Sophrinix/Acoustic-Tractor-Beam/README.rst

# AcousticTractorBeam

********************************
Acoustic Tractor Beam
********************************
Levitate objects using waves.

Using the guidance from Asier Marzo in his instructable:
http://www.instructables.com/id/Acoustic-Tractor-Beam/?ALLSTEPS

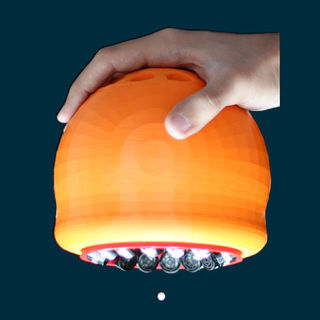
[picture p1: images/1.jpg]
   
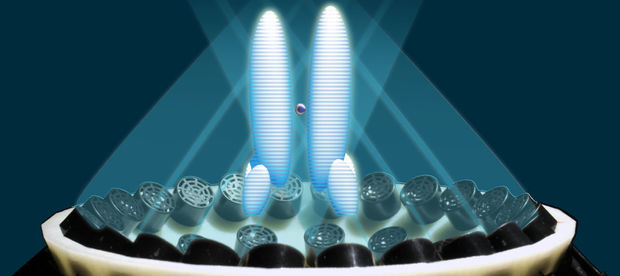
[picture p2: images/2.jpg]
   
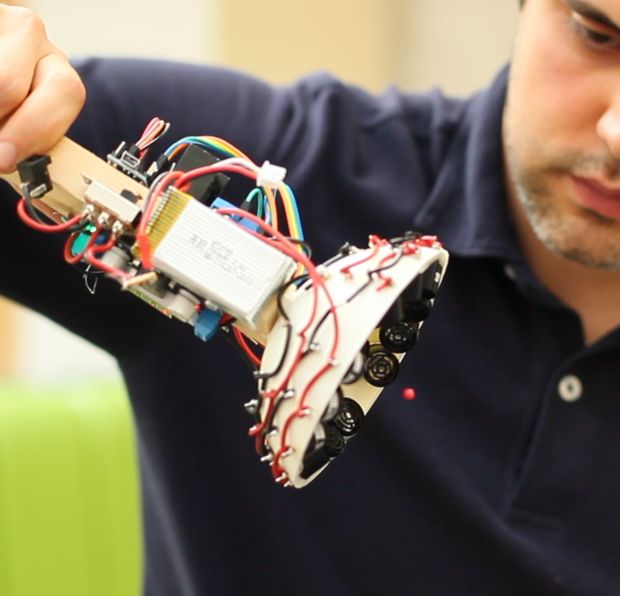
[picture p3: images/3.jpg]
