Sophrinix/Acoustic-Tractor-Beam/docs/AcousticTractorBeam_Instructable.pdf

http://www.instructables.com/id/Acoustic-Tractor-Beam/technology (http://www.instructables.com/tag/type-id/category-technology/) workshop (http://www.instructables.com/tag/type-id/category-workshop/) craft (http://www.instructables.com/tag/type-id/category-craft/) home (http://www.instructables.com/tag/type-id/category-home/) food (http://www.instructables.com/tag/type-id/category-food/) play (http://www.instructables.com/tag/type-id/category-play/) outside (http://www.instructables.com/tag/type-id/category-outside/) costumes (http://www.instructables.com/tag/type-id/category-costumes/)

# Acoustic Tractor Beam

by Asier Marzo on December 13, 2016

Table of Contents

Author:Asier Marzo author's website (http://asiermarzo.wordpress.com)
Researcher at Bristol University interesting in Ultrasound and in general any effects that waves can produce.

## Intro: Acoustic Tractor Beam

Tractor Beams are mysterious waves that can attract particles towards the source. Here, we will show you how to build an Acoustic Tractor Beam with components that can be bought directly on the Internet for less than 75$.

With this Instructable you will be able to get in your hands a device that it was only seen on SciFi movies such as Star Wars or Star Trek.

If you want more scientific background on Acoustic Tractor Beams, you can check our Open Access papers:
How Acoustic Tractor Beams Work (http://www.nature.com/articles/ncomms9661)
Acoustic Delay Lines for Compact Tractor beams (http://aip.scitation.org/doi/full/10.1063/1.4972407)

Do not forget to watch the attached video.

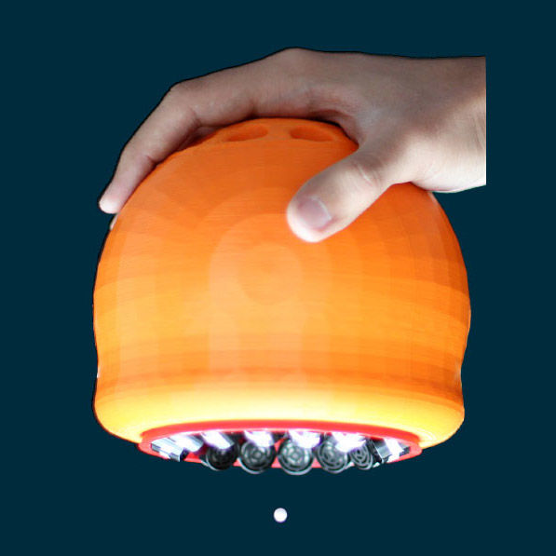
[picture p4: figure]
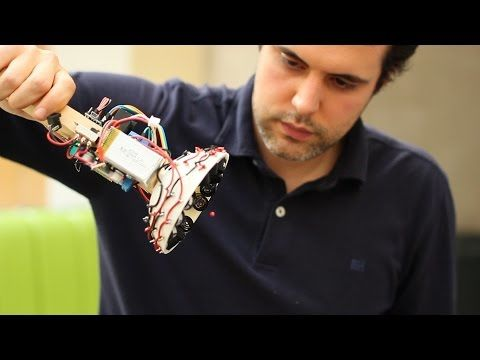
[picture p5: figure]

## Step 1: Gather the parts and tools

We present a list of the necessary components. We are sorry since the links are UK oriented. However, the same parts can be found all around the world, some useful websites are http://www.findchips.com/ http://www.dx.com/ http://www.miniinthebox.com/http://www.lightinthebox.com/

The circuit is not complicated. Basically, an Arduino will generate 4 half-square signals at 5Vpp 40kHz with different phases. These signals get amplified to 25Vpp by the Motor Driver and fed into the transducers. A button pad can be used to change the phases so that the particle moves up and down. A battery (7.3V) powers the Arduino and the logic part of the Motor Driver. A DC-DC Converter steps-up the 7.3V to 25V for the Motor Driver.

Components:
30x 16mm Transducers MCUSD16P40B12RO (http://uk.farnell.com/webapp/wcs/stores/servlet/ProductDisplay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)

1x Arduino Nano (http://www.amazon.co.uk/dp/B015MGHH6Q)
1x L298N Dual Motor Drive Board (http://www.amazon.co.uk/dp/B00GKF60Z8)
1x DCtoDC converter (http://www.amazon.co.uk/dp/B00J0V6MCK)
1x 2S Lipo Battery (7.3V) + charger (http://www.amazon.co.uk/dp/B01AXQN9MG) 11x M3 screws 6mm (http://www.amazon.co.uk/dp/B00DY2980Y) and M3 nuts (http://www.amazon.co.uk/dp/B00O7RRKXC) 1x 300x45x15mm wood piece
1x 3D Printed Bowl
1x Small strip board (http://www.amazon.co.uk/dp/B00KM1EG0M)
1x switch (http://www.amazon.co.uk/dp/B008DFYNX4)
3x breadboard buttons (http://www.amazon.co.uk/dp/B00976KDBY)
Jumper wires (http://www.amazon.co.uk/dp/B018W4L6D0)
12AWG black and red wire (http://www.amazon.co.uk/dp/B01H1WMCT6)
Some Expanded Polystyrene beads to levitate (between 1mm and 4mm diameter) An acoustically transparent material: A metallic grid, very thin fabric or teabag paper.

Necessary Tools:
3D printer -> you can use an online service

Oscilloscope with two probes -> you can get one for less than 50£ http://amzn.eu/5ey6ty2

Soldering Iron, Tin and Flux.
Drill
Hot-glue gun
Multimeter
Cable Peeler
Screwdriver and Pliers.

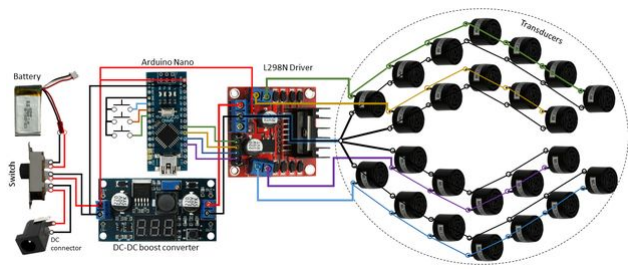
[picture p6: figure]

## Step 2: 3D print the bowl

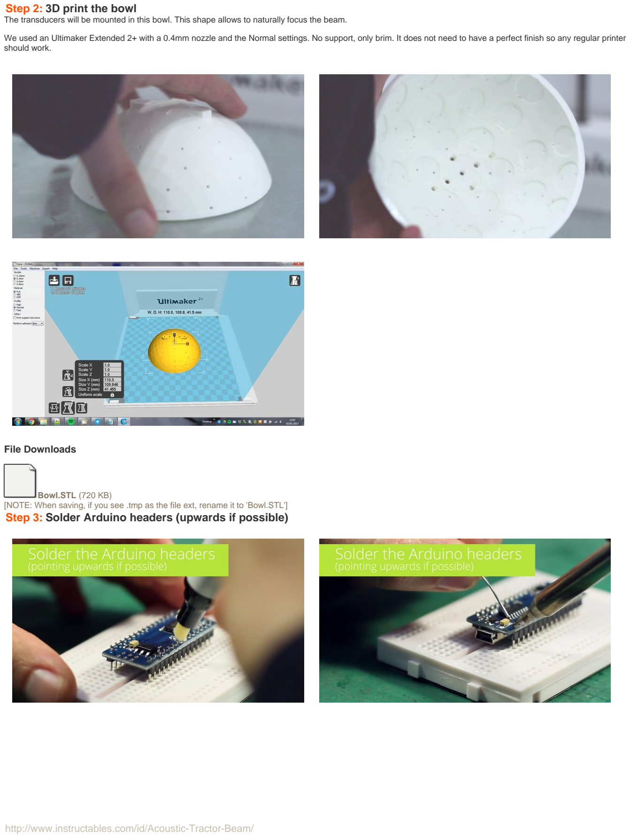
[picture p7: page 5]

The transducers will be mounted in this bowl. This shape allows to naturally focus the beam.

We used an Ultimaker Extended 2+ with a 0.4mm nozzle and the Normal settings. No support, only brim. It does not need to have a perfect finish so any regular printer should work.

File Downloads

Bowl.STL (http://www.instructables.comhttps://cdn.instructables.com/ORIG/FM7/UD6W/IWMQUV05/FM7UD6WIWMQUV05.stl) (720 KB)
[NOTE: When saving, if you see .tmp as the file ext, rename it to 'Bowl.STL'] (http://www.instructables.comhttps://cdn.instructables.com/ORIG/FM7/UD6W/IWMQUV05/FM7UD6WIWMQUV05.stl)

## Step 3: Solder Arduino headers (upwards if possible)

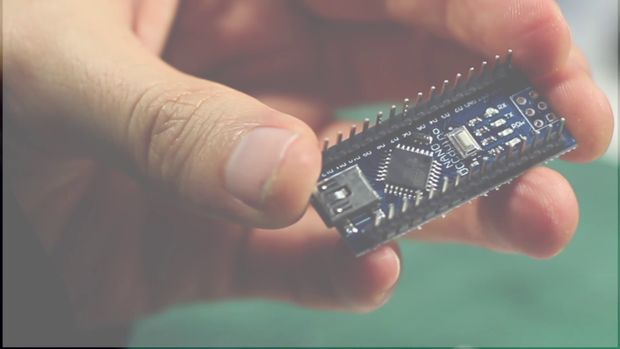
[picture p8: figure]

## Step 4: Program Arduino

Upload the attached program in the Arduino Nano. If you are using a cheap Nano (totally recommendable) you will need to install new drivers, there are usually links in the webpage where you bought it.

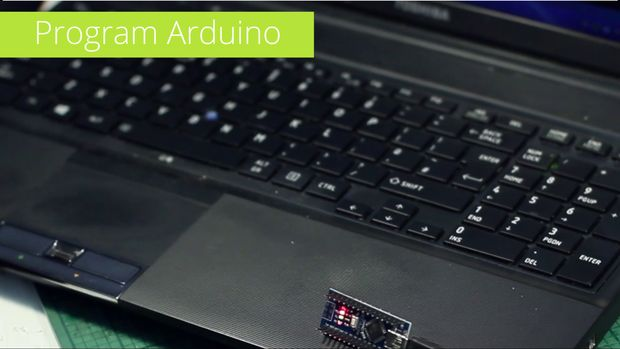
[picture p9: figure]

File Downloads

DriverNano_tractor.ino (http://www.instructables.comhttps://cdn.instructables.com/ORIG/F32/XCJP/IWMQUV4D/F32XCJPIWMQUV4D.ino) (7 KB)
[NOTE: When saving, if you see .tmp as the file ext, rename it to 'DriverNano_tractor.ino'] (http://www.instructables.comhttps://cdn.instructables.com/ORIG/F32/XCJP/IWMQUV4D/F32XCJPIWMQUV4D.ino)

## Step 5: Charge the battery

This way when you finish the project it will be at full charge.

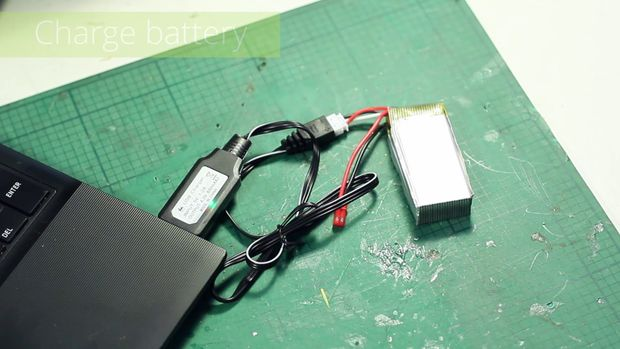
[picture p10: figure]

## Step 6: Cut the handler

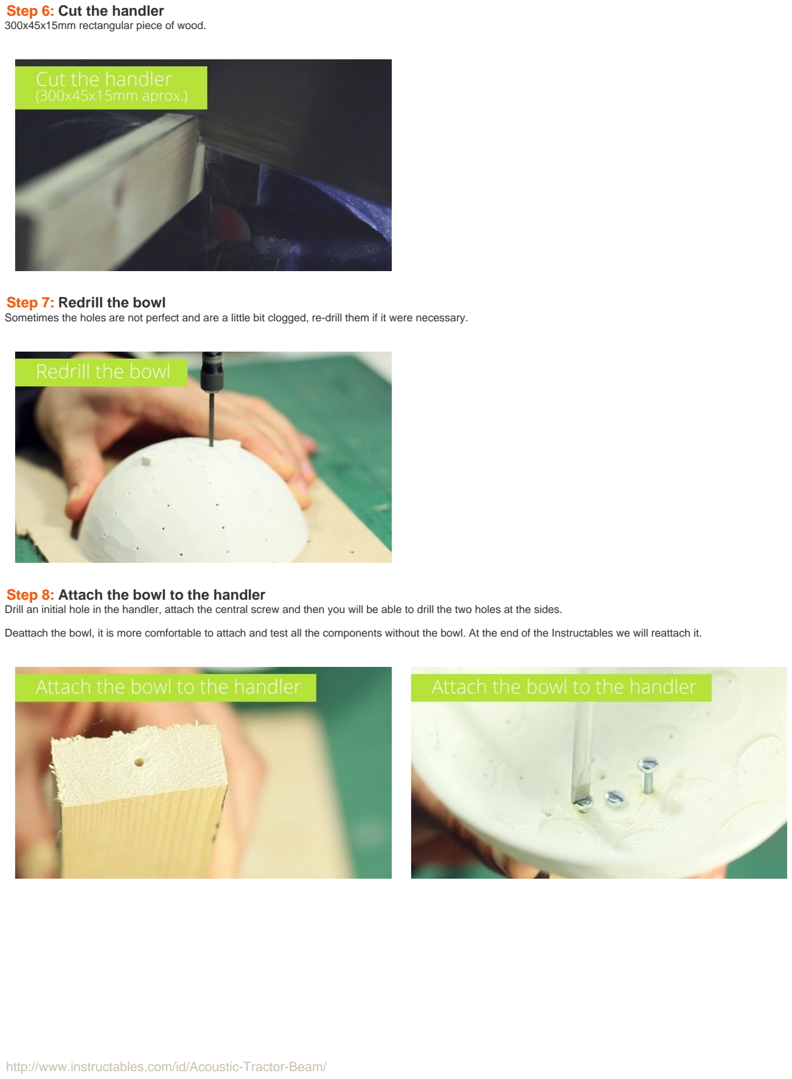
[picture p11: page 7]

300x45x15mm rectangular piece of wood.

## Step 7: Redrill the bowl

Sometimes the holes are not perfect and are a little bit clogged, re-drill them if it were necessary.

## Step 8: Attach the bowl to the handler

Drill an initial hole in the handler, attach the central screw and then you will be able to drill the two holes at the sides.

Deattach the bowl, it is more comfortable to attach and test all the components without the bowl. At the end of the Instructables we will reattach it.

## Step 9: Screw the DCConverter and the Driver

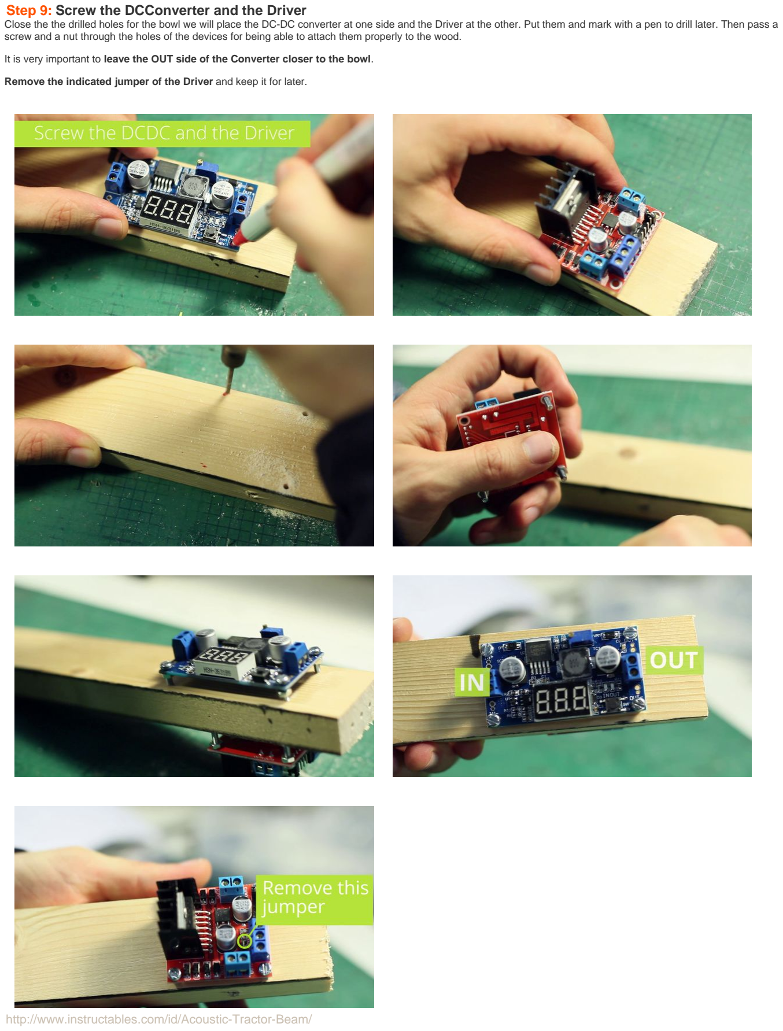
[picture p12: page 8]

Close the the drilled holes for the bowl we will place the DC-DC converter at one side and the Driver at the other. Put them and mark with a pen to drill later. Then pass a screw and a nut through the holes of the devices for being able to attach them properly to the wood.

It is very important to leave the OUT side of the Converter closer to the bowl.

Remove the indicated jumper of the Driver and keep it for later.

## Step 10: Stick the arduino

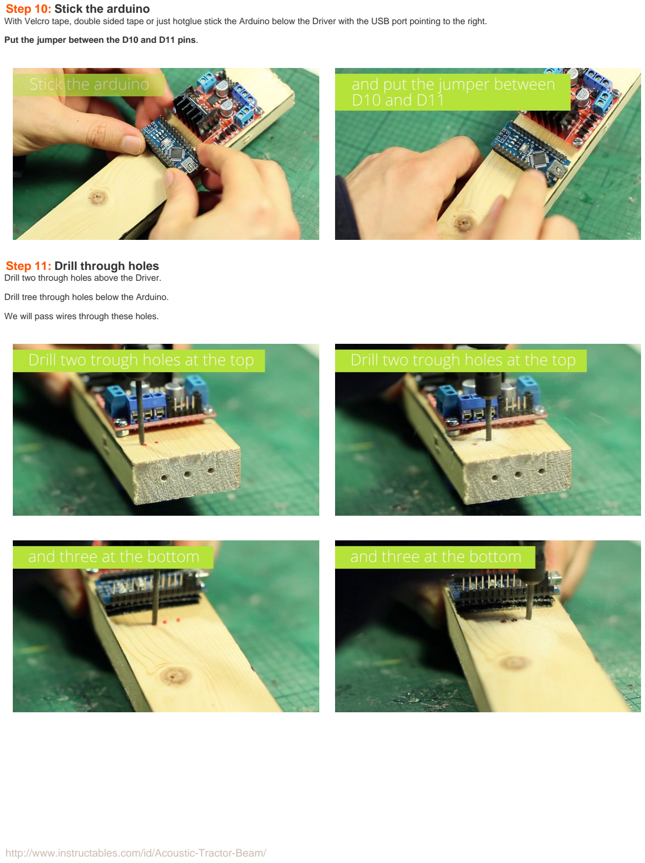
[picture p13: page 9]

With Velcro tape, double sided tape or just hotglue stick the Arduino below the Driver with the USB port pointing to the right.

Put the jumper between the D10 and D11 pins.

## Step 11: Drill through holes

Drill two through holes above the Driver.

Drill tree through holes below the Arduino.

We will pass wires through these holes.

## Step 12: Solder wires to the power switch

The central pins provides the current to the circuit, the right pins go to the DC barrel and the left ones to the battery connector pins.

Try to use red wires for (+) and black for ground (-) to keep things ordered. Pay attention to where the + and - of the DC barrel go and solder it appropriately.

For the battery connector pins we can use pin headers and a tiny piece of strip-board. Be sure that the wires are not touching each other (use a multimeter), and even put hotglue between them to make them safer.

The power switch provides current to the circuit either from a DC barrel or from the battery.

We can use any DC adaptor between 9V and 12V that can provide at least 2A if you do not want to use a battery.

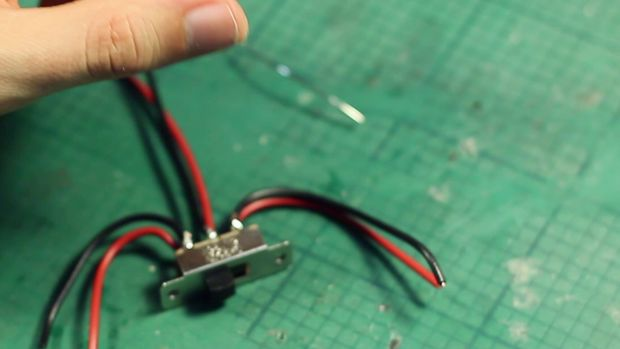
[picture p14: figure]
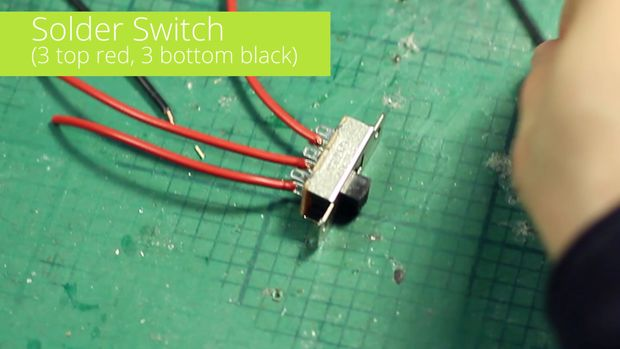
[picture p15: figure]
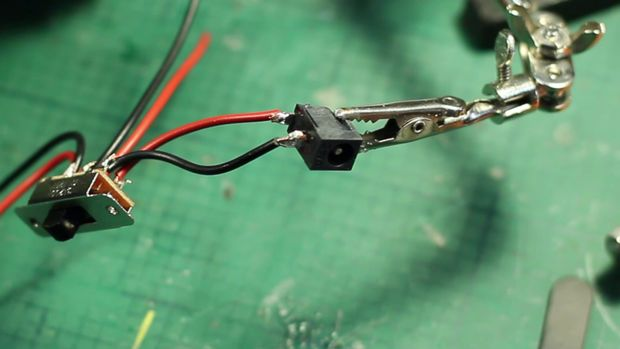
[picture p16: figure]
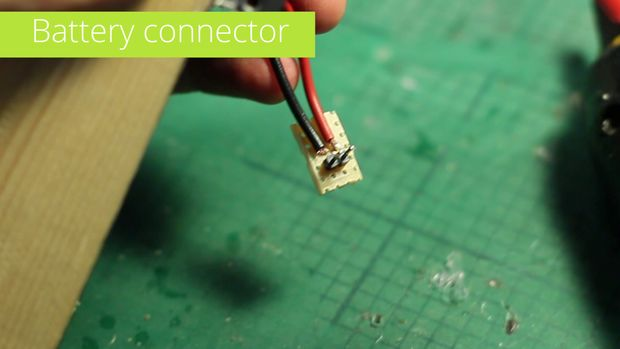
[picture p17: figure]
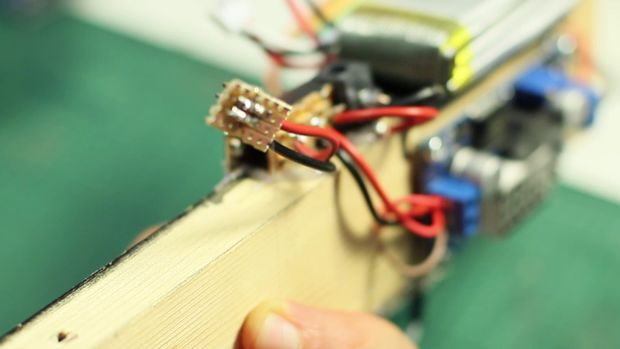
[picture p18: figure]

## Step 13: Stick the battery

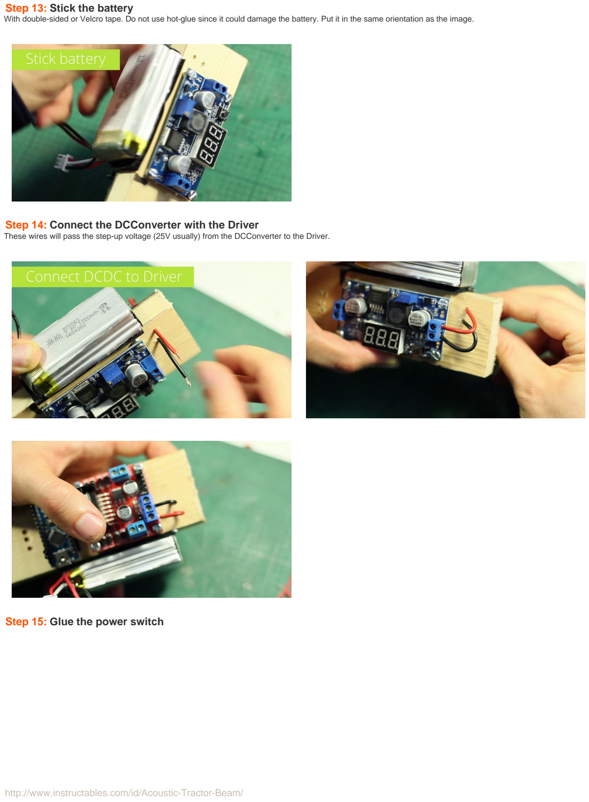
[picture p19: page 11]

With double-sided or Velcro tape. Do not use hot-glue since it could damage the battery. Put it in the same orientation as the image.

## Step 14: Connect the DCConverter with the Driver

These wires will pass the step-up voltage (25V usually) from the DCConverter to the Driver.

## Step 15: Glue the power switch

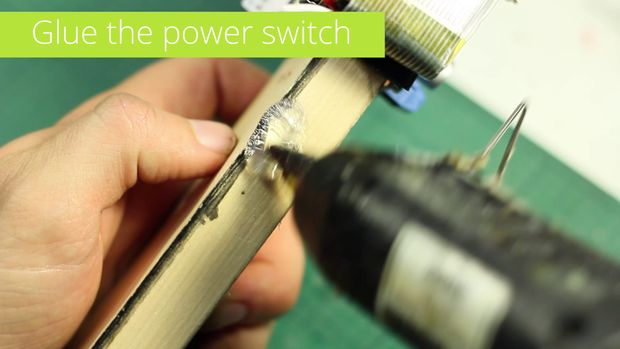
[picture p20: figure]
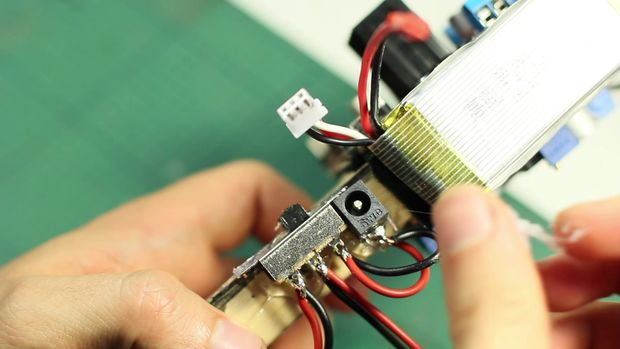
[picture p21: figure]

## Step 16: Connect logic supply

We will provide 7.4V to the DCConverter IN.

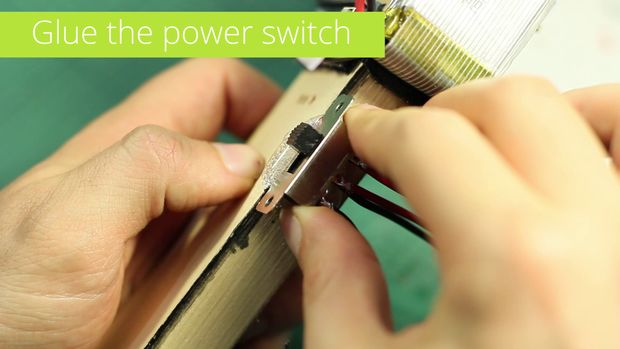
[picture p22: figure]

First connect the black ground wire (-) from the central pins of the Switch into the DCConverter IN(-), in the same hole connect the ground for the Arduino.

Then, connect the red (+) wire from the central pin of Switch into the DCConverter IN(+), in the same hole put the VIn of the Arduino and the logic supply for the converter (pins from where we removed the jumper, very important to connect it into the highlighted pin).

Tining the tips of the wires will facilitate putting several wires in the same hole.

It is also possible to get voltage for the Arduino from the DCConverter. Instead of connecting Converter.IN(+) to Arduino.VIn, we can use DCConverter(5V) to Arduino(V5).

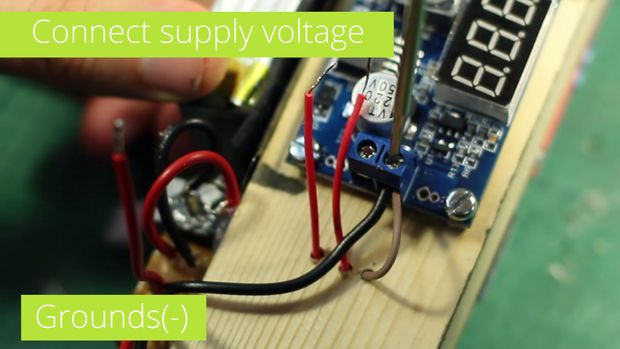
[picture p23: figure]
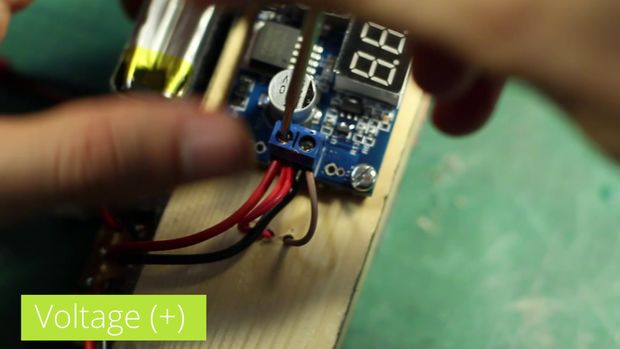
[picture p24: figure]

## Step 17: Connect signal wires

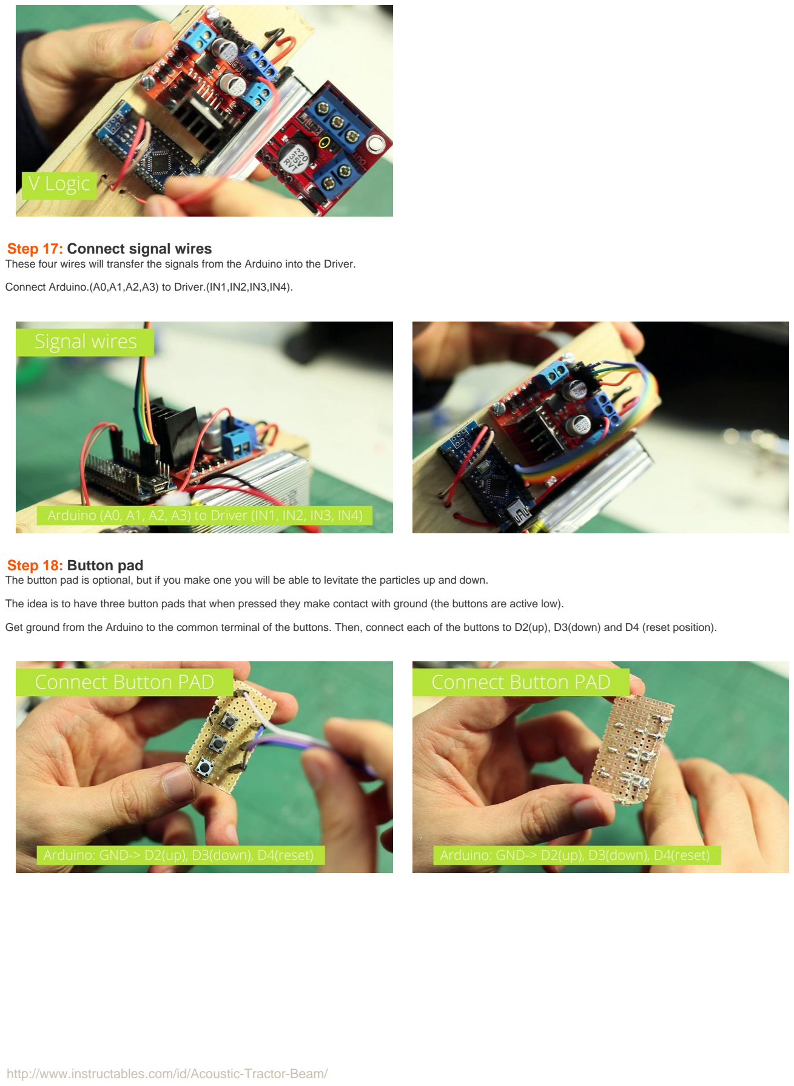
[picture p25: page 13]

These four wires will transfer the signals from the Arduino into the Driver.

Connect Arduino.(A0,A1,A2,A3) to Driver.(IN1,IN2,IN3,IN4).

## Step 18: Button pad

The button pad is optional, but if you make one you will be able to levitate the particles up and down.

The idea is to have three button pads that when pressed they make contact with ground (the buttons are active low).

Get ground from the Arduino to the common terminal of the buttons. Then, connect each of the buttons to D2(up), D3(down) and D4 (reset position).

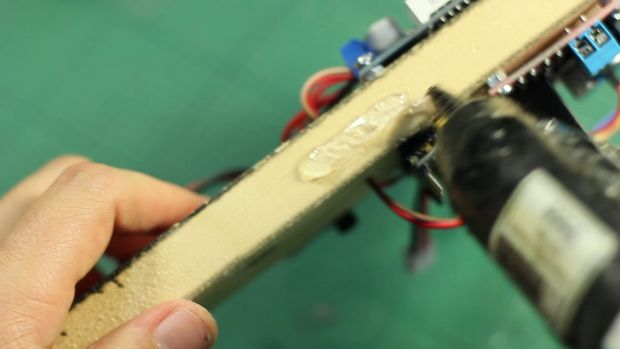
[picture p26: figure]

## Step 19: Set the voltage to 10V

First Connect the battery (be sure to use the right polarity).

Switch on the device.

Rotate the potentiometer counterclockwise until you see 10V in the display.

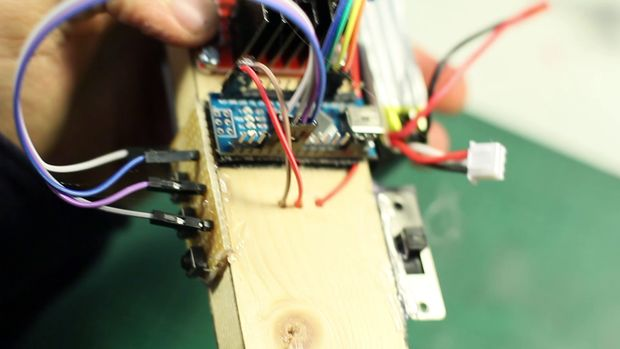
[picture p27: figure]

In the final device we will use 25V but it is safer for the test equipment to work at 10V. If you use X10 probes then it is alright to use 25V throughout the process.

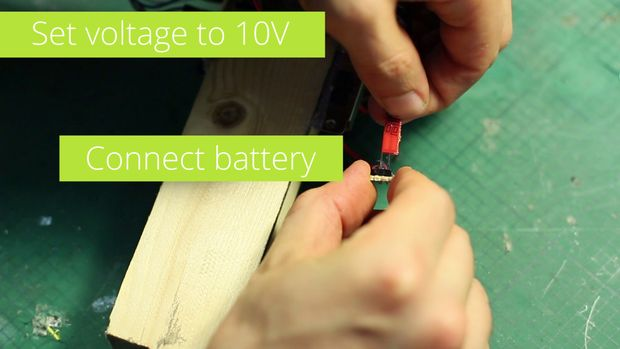
[picture p28: figure]

## Step 20: Test the signals

This step is optional but it is about time to check that everything is working fine.

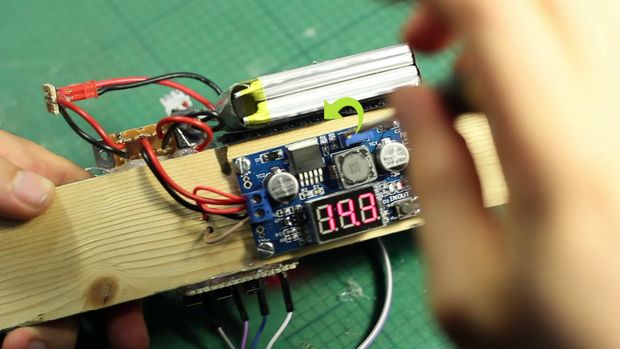
[picture p29: figure]

Get two probes and connect the grounds to a ground of the circuit, temporarily using the button pad ground is one of the easiest options. Remember to put it back when finished.

Before the driver the signals should be 5Vpp and after the driver 10Vpp.

Signals from the same side are in phase while signals from opposite sides should be out of phase.

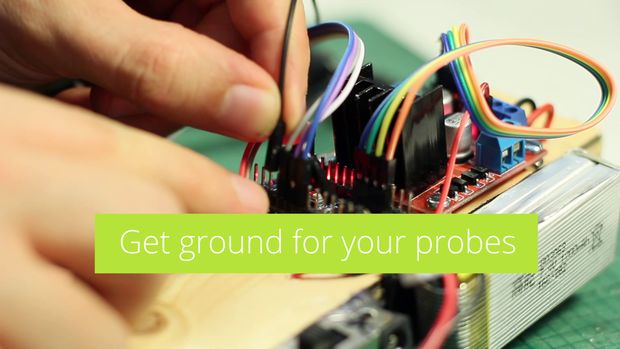
[picture p30: figure]
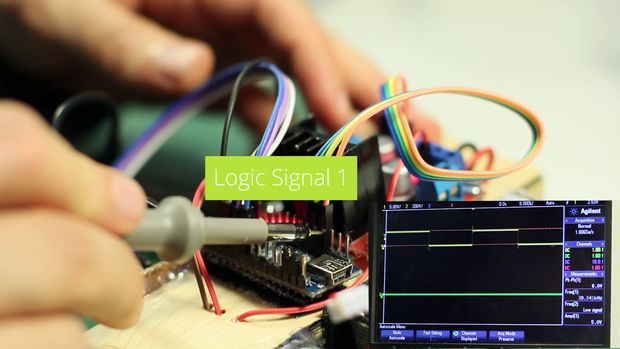
[picture p31: figure]

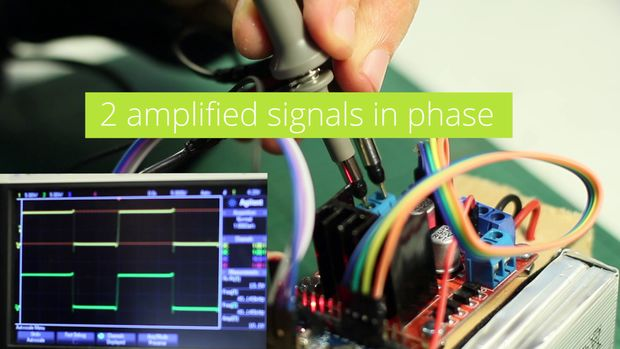
[picture p32: figure]

## Step 21: Mark the transducers (hard method)

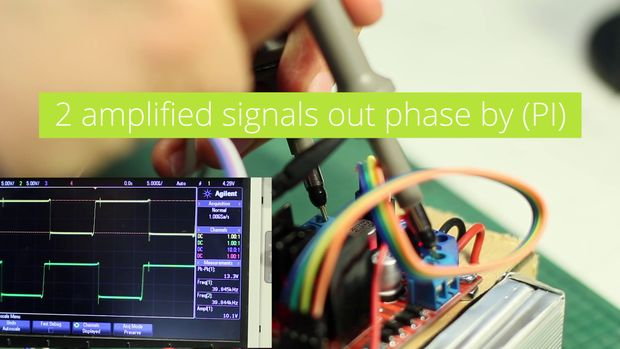
[picture p33: figure]

The transducers have polarity and they need to be marked. Do not trust manufacturer marks since they can be wrong.

This method is the one contained in the video, but we have an alternative one that is much easier one in the next step.

First take ground and voltage from any of the Driver outputs. Connect them to a transducer and also connect one probe to the same transducer. This probe will capture the emitted signal.

Take another probe and connect it to the transducer that needs to be marked, this will be the received signal.

Put the transducers face to face and check the signals in the scope.

If the signals are in phase, mark the leg connected to ground. If they are out of phase, mark the other leg.

Mark all the transducers.

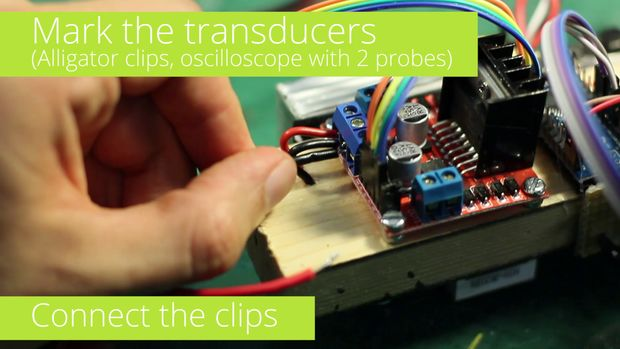
[picture p34: figure]
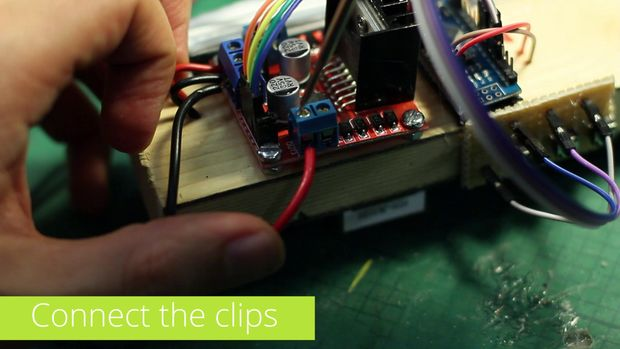
[picture p35: figure]
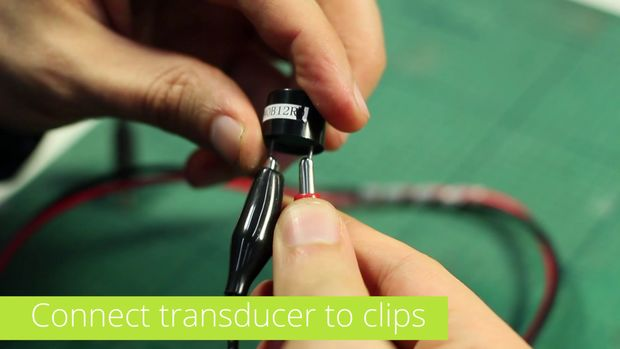
[picture p36: figure]
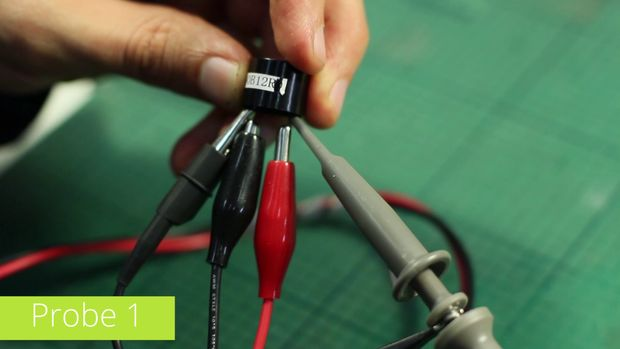
[picture p37: figure]
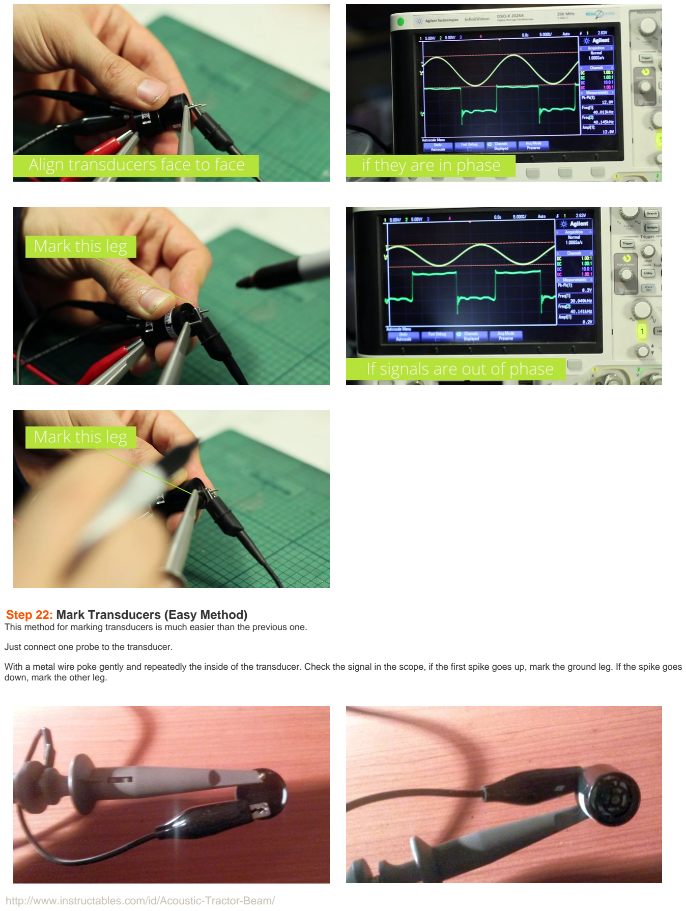
[picture p38: page 16]

## Step 22: Mark Transducers (Easy Method)

This method for marking transducers is much easier than the previous one.

Just connect one probe to the transducer.

With a metal wire poke gently and repeatedly the inside of the transducer. Check the signal in the scope, if the first spike goes up, mark the ground leg. If the spike goes down, mark the other leg.

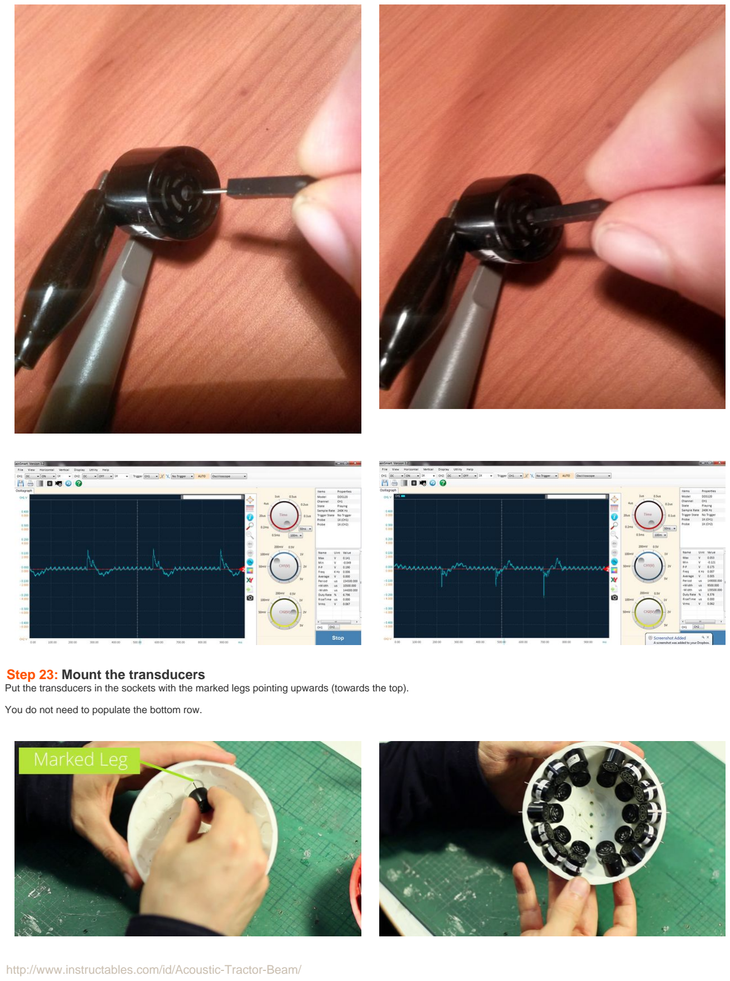
[picture p39: page 17]

## Step 23: Mount the transducers

Put the transducers in the sockets with the marked legs pointing upwards (towards the top).

You do not need to populate the bottom row.

## Step 24: Wire the transducers

We need to wire the transducers to deliver power into them.

Measure the needed length for the wire and give three extra hands for connecting it later.

With the cable peeler, partially peel at the correct distance, later these exposed parts will be twisted around the transducers legs.

Once that you have made the cuts with the peeler, redistribute the plastic to keep a uniform length of cooper exposed. Twist the cooper wires to make them more solid. Twist the exposed parts around the transducers legs, apply flux and solder.

Follow the pattern presented in the images. That is, all the grounds are connected together. The red wires of the same half go towards the same side.

Pay attention to the numbers, these numbers correspond to the driver numbers.

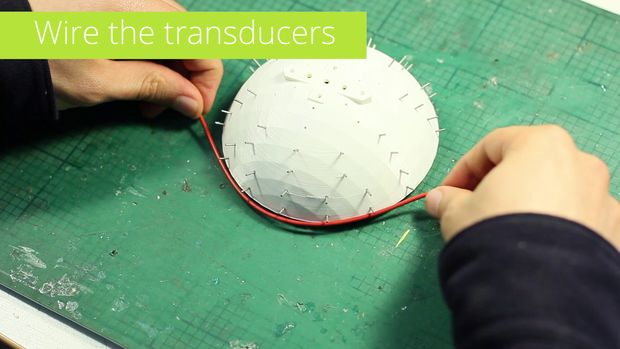
[picture p40: figure]
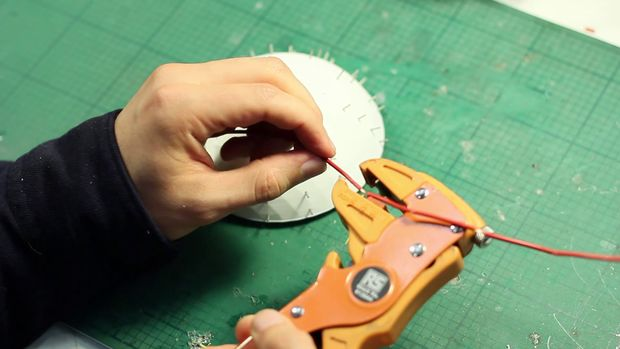
[picture p41: figure]
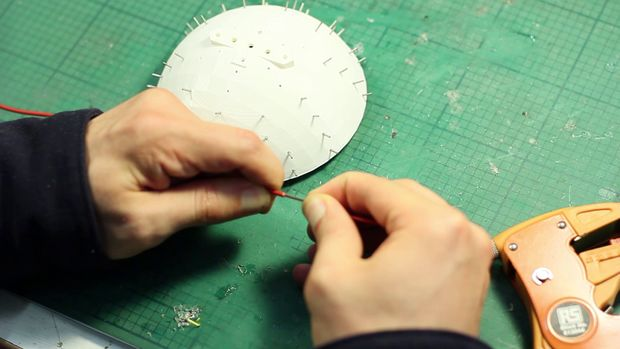
[picture p42: figure]
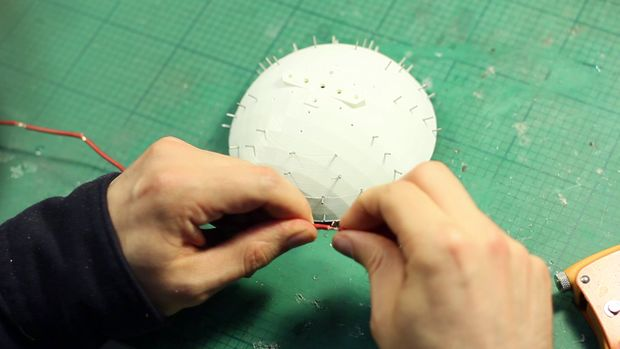
[picture p43: figure]
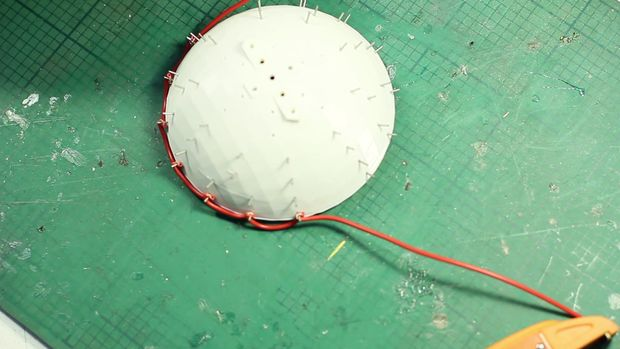
[picture p44: figure]
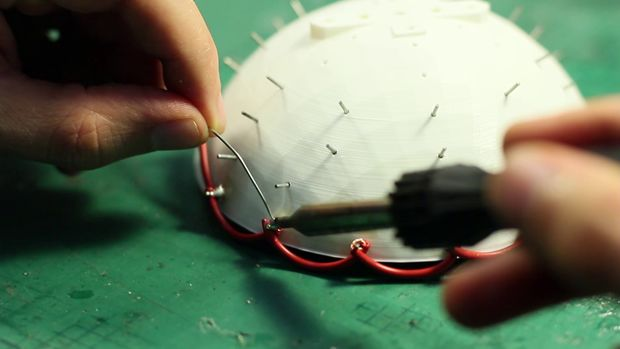
[picture p45: figure]

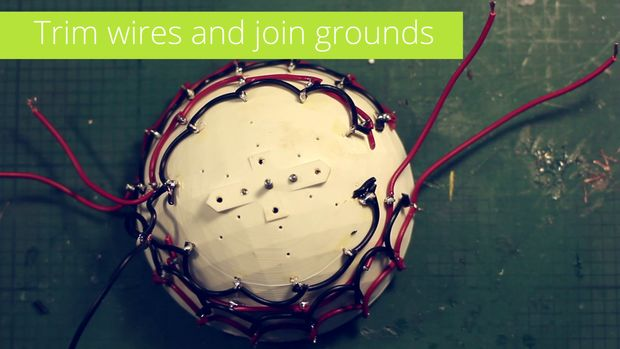
[picture p46: figure]

## Step 25: Test the transducers

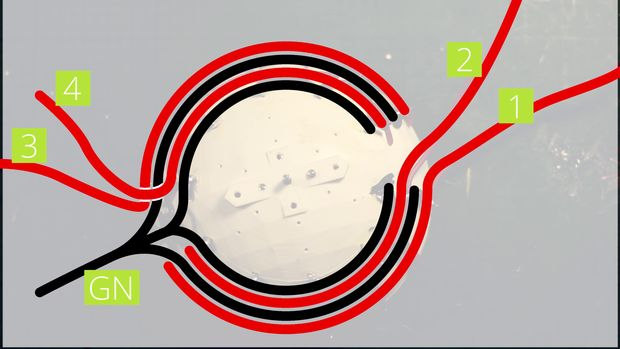
[picture p47: figure]

This step is optional but it is convenient to check that all the transducers are connected correctly.

Connect the ground from the bowl into the driver ground (there will be another wire there).

Connect the 4 red wires from the bowl into the outputs of the Driver, respect the numbering.

Connect two extra marked transducers to the scope probes. Be sure to connect the ground into the marked leg (or at least connect the two transducers in the same way). With these transducers we can check the emitted signal of other transducers.

Transducers from the same half of the bowl should emit in phase. Transducers from opposite halves emit out of phase.

Transducers with the wrong polarity should be desoldered, rotated and resoldered.

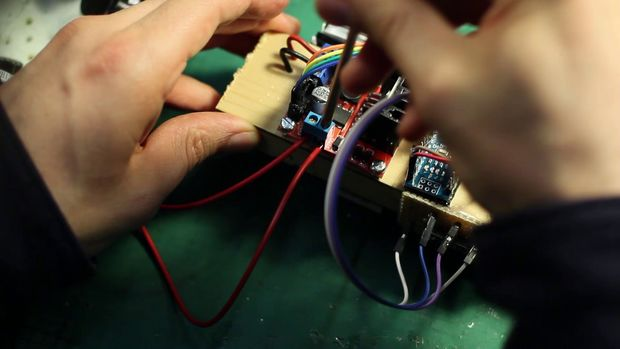
[picture p48: figure]
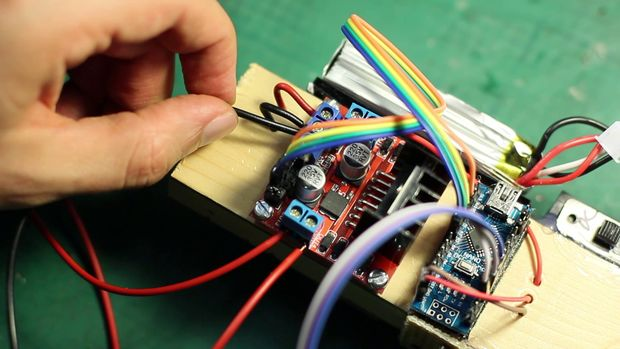
[picture p49: figure]
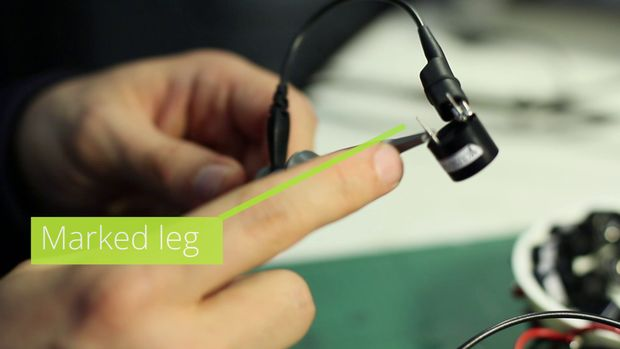
[picture p50: figure]
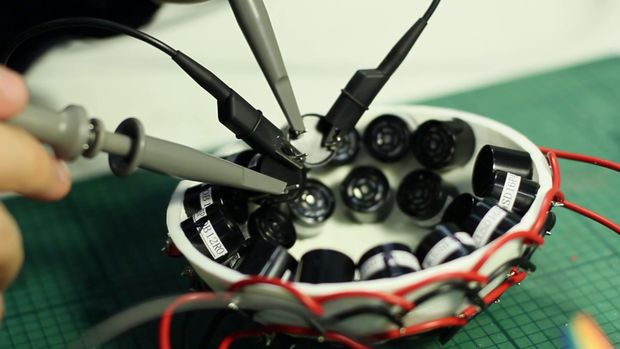
[picture p51: figure]

## Step 26: Set voltage to 25v

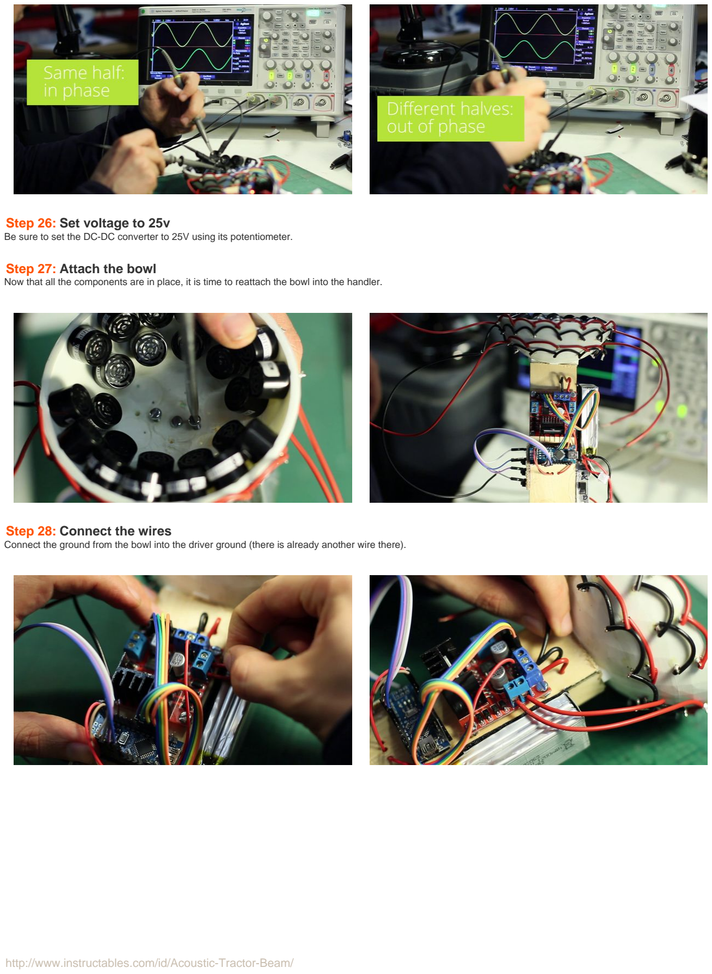
[picture p52: page 20]

Be sure to set the DC-DC converter to 25V using its potentiometer.

## Step 27: Attach the bowl

Now that all the components are in place, it is time to reattach the bowl into the handler.

## Step 28: Connect the wires

Connect the ground from the bowl into the driver ground (there is already another wire there).

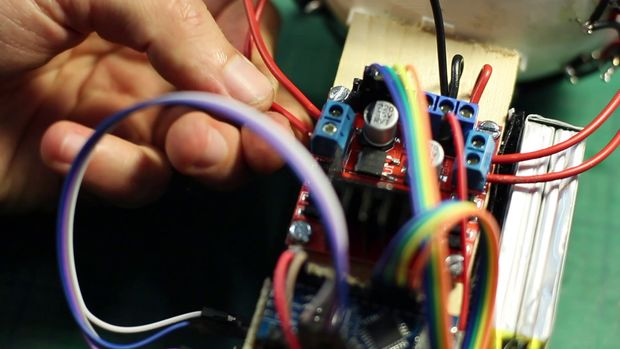
[picture p53: figure]

## Step 29: Switch On and levitate

Switch on the device, you should be able to feel a little bit the sound, or hear it if you point it into a big chunk of expanded polystyrene or foam.

Using an acoustically transparent sheet or tweezers you can place particles in the centre of the bowl (above 1.8cm approx) and they will be levitated.

Push the buttons to move the particle up or down.

Depending on the size of the particle and how close it is to the bowl, you will be able to levitate it laterally or upside down. It is also possible to levitate particles that are resting on a surface.

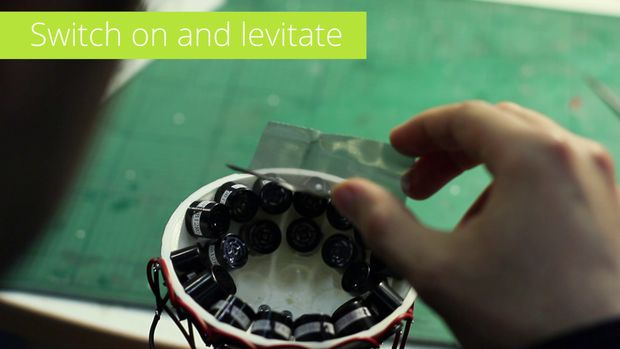
[picture p54: figure]
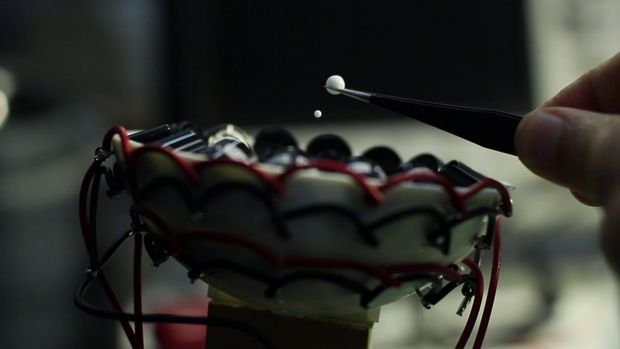
[picture p55: figure]

## Step 30: Building Other Sonic Devices (Optional)

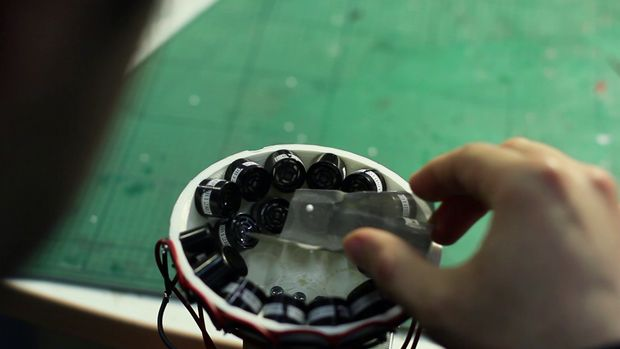
[picture p56: figure]
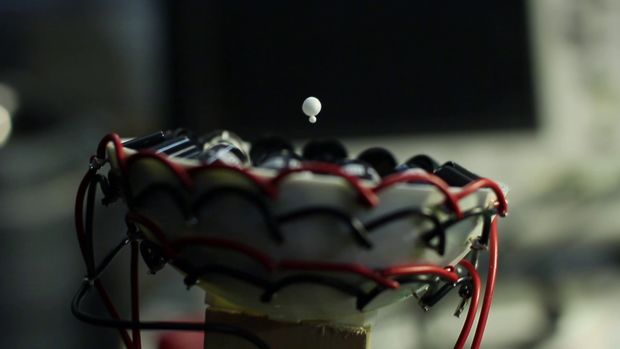
[picture p57: figure]

We have presented how to build the most efficient device but there are others that require even less electronics although they are not as efficient in terms of levitation power to watts.

For the following devices you will need smaller transducers, wires and connectors, as well as a different version for the Arduino (that generates always a 40kHZ signal).

1cm transducers MA40S4S (http://uk.rs-online.com/web/p/ultrasonic-proximity-sensors/2370799/?searchTerm=MA40S4S)
Ribbon Wires 10 Way Unscreened Flat Ribbon Cable, 12.7 mm Width (http://uk.rs-online.com/web/p/flat-ribbon-cable/2140661/)
Connector (for the small transducers) Right Angle Cable Mount IDC Connector Socket, 3 Way, 1 Row, 2.54mm Pitch (http://uk.rs-online.com/web/p/idc-connectors/5067014/)
8x2 female Connector Wire-To-Board Connector, Vertical,16 Contacts, Header, 2.54 mm, Through Hole, 2 Rows (http://uk.farnell.com/webapp/wcs/stores/servlet/ProductDisplay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) 8x2 male Connector Right Angle Cable Mount IDC Connector Socket, 16 Way, 2 Row, 2.54mm Pitch (http://uk.rs-online.com/web/p/idc-connectors/3237873/)

File Downloads

Signal40Khz.ino (http://www.instructables.comhttps://cdn.instructables.com/ORIG/FSW/0YWZ/IXGFQ640/FSW0YWZIXGFQ640.ino) (1 KB)
[NOTE: When saving, if you see .tmp as the file ext, rename it to 'Signal40Khz.ino'] (http://www.instructables.comhttps://cdn.instructables.com/ORIG/FSW/0YWZ/IXGFQ640/FSW0YWZIXGFQ640.ino)

## Step 31: Coils Device (Optional)

Print the attached STL file. The transducers are fit in the bottom holes and they are all driven with the same signal.

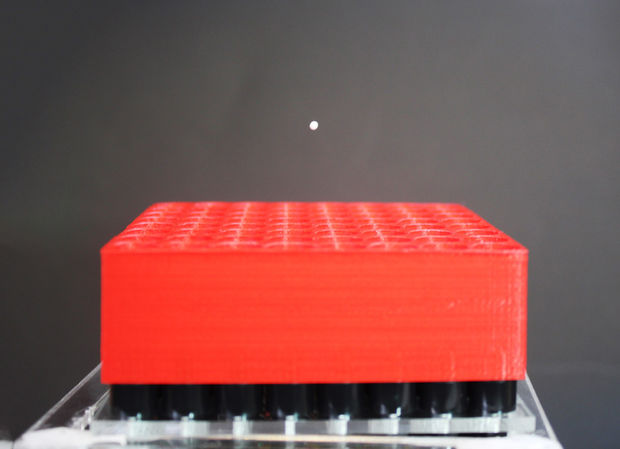
[picture p58: figure]
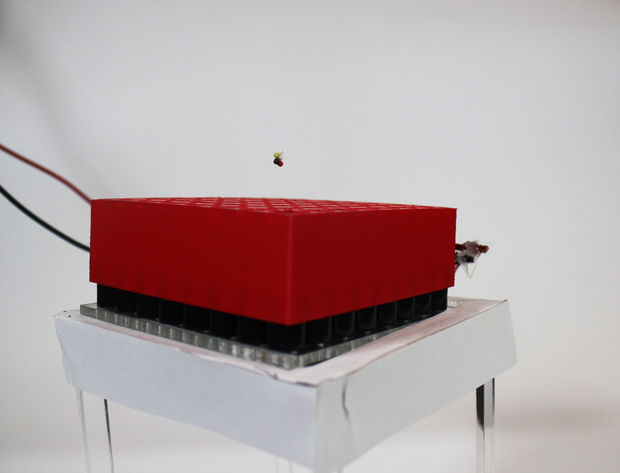
[picture p59: figure]

File Downloads

Coils.stl (http://www.instructables.comhttps://cdn.instructables.com/ORIG/FD6/4RYX/IXGFQ7SL/FD64RYXIXGFQ7SL.stl) (10 MB)
[NOTE: When saving, if you see .tmp as the file ext, rename it to 'Coils.stl'] (http://www.instructables.comhttps://cdn.instructables.com/ORIG/FD6/4RYX/IXGFQ7SL/FD64RYXIXGFQ7SL.stl)

## Step 32: Tubes devices

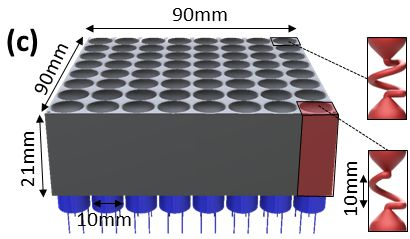
[picture p60: figure]

Print the attached STL file. The transducers are fit in the bottom holes and they are all driven with the same signal.

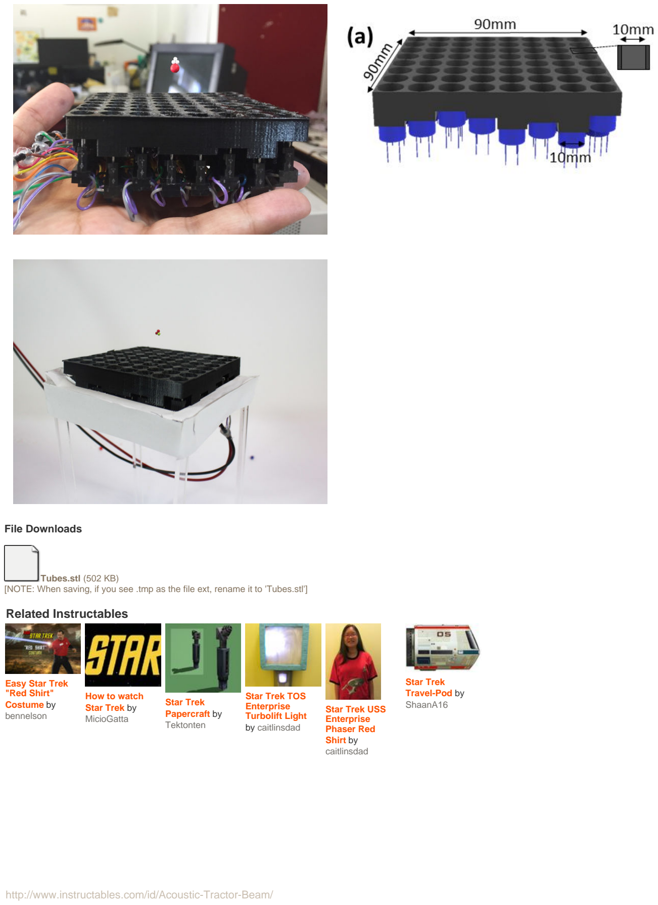
[picture p61: page 23]

File Downloads

Tubes.stl (http://www.instructables.comhttps://cdn.instructables.com/ORIG/FTM/PLJK/IXGFQ8KX/FTMPLJKIXGFQ8KX.stl) (502 KB)
[NOTE: When saving, if you see .tmp as the file ext, rename it to 'Tubes.stl'] (http://www.instructables.comhttps://cdn.instructables.com/ORIG/FTM/PLJK/IXGFQ8KX/FTMPLJKIXGFQ8KX.stl)

## Related Instructables

Easy Star Trek
"Red Shirt"
Costume (http://www.instructables.com/id/Easy-Star-Trek-Red-Shirt-Costume/) by
bennelson (http://www.instructables.com/member/bennelson/?utm_source=pdf&utm_campaign=related)

How to watch
Star Trek (http://www.instructables.com/id/How-to-watch-Star-Trek/?utm_source=pdf&utm_campaign=related) by
MicioGatta (http://www.instructables.com/member/MicioGatta/?utm_source=pdf&utm_campaign=related)

Star Trek
Papercraft (http://www.instructables.com/id/Star-Trek-Papercraft-1/?utm_source=pdf&utm_campaign=related) by
Tektonten (http://www.instructables.com/member/Tektonten/?utm_source=pdf&utm_campaign=related)

Star Trek TOS
Enterprise
Turbolift Light (http://www.instructables.com/id/Star-Trek-TOS-Enterprise-Turbolift-Light/)
by caitlinsdad (http://www.instructables.com/member/caitlinsdad/?utm_source=pdf&utm_campaign=related)

Star Trek USS
Enterprise
Phaser Red
Shirt (http://www.instructables.com/id/Star-Trek-USS-Enterprise-Phaser-Red-Shirt/) by
caitlinsdad (http://www.instructables.com/member/caitlinsdad/?utm_source=pdf&utm_campaign=related)

Star Trek
Travel-Pod (http://www.instructables.com/id/Star-Trek-Travel-Pod/?utm_source=pdf&utm_campaign=related) by
ShaanA16 (http://www.instructables.com/member/ShaanA16/?utm_source=pdf&utm_campaign=related)

Advertisements

## Comments

2 comments | Add Comment (http://www.instructables.com/id/Acoustic-Tractor-Beam/?utm_source=pdf&utm_campaign=comments#comments)
Tecwyn Twmffat (http://www.instructables.com/member/Tecwyn+Twmffat/?utm_source=pdf&utm_campaign=comments) says: | Jan 3, 2017. 11:18 AM REPLY (http://www.instructables.com/id/Acoustic-Tractor-Beam/?utm_source=pdf&utm_campaign=comments#DISCUSS)
You got my votes! ...... Eh Jim lad.
onion2 (http://www.instructables.com/member/onion2/?utm_source=pdf&utm_campaign=comments) says: | Jan 3, 2017. 10:38 AM REPLY (http://www.instructables.com/id/Acoustic-Tractor-Beam/?utm_source=pdf&utm_campaign=comments#DISCUSS)
woooh, amazing
